saivenkatakrish/rice-sorting-lvds-camera-synchronization/rice-sorting-lvds-camera-synchronization/Documentation/system_architecture.png

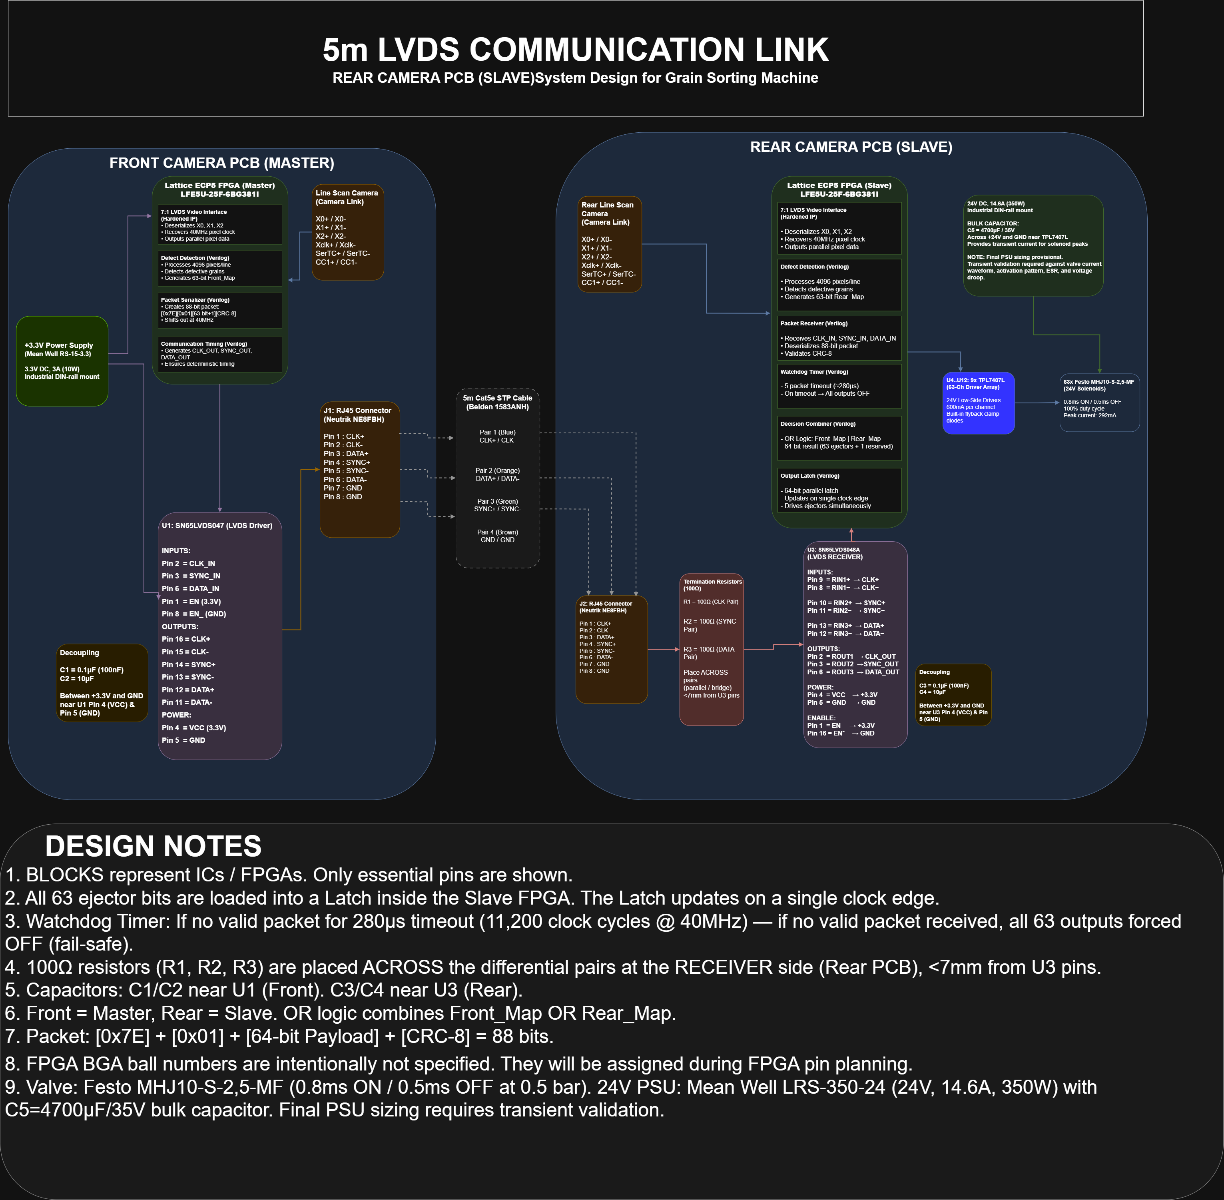
rice-sorting-lvds-camera-synchronization/Documentation/system_architecture.png
