saivenkatakrish/rice-sorting-lvds-camera-synchronization/rice-sorting-lvds-camera-synchronization/BOM/BOM_Rice_Sorter_MACHINE.xlsx

Bill of Materials — Rice Sorter FPGA Board
S.NO | Reference(s) | Value | Description | MPN / Part No. | Quantity | Datasheet
1 | C1, C4, C5, C11, C13, C18, C23, C24, C_BULK_3V3, C_BULK_3V_1 | 10µF | Ceramic Capacitor 10µF 10V X5R 0603 | GRM188R61A106KE69D | 10 | Datasheet ↗ (https://datasheet.octopart.com/GRM188R61A106KE69D-Murata-datasheet-138742815.pdf)
2 | C2, C6, C7, C8, C9, C10, C15, C16, C19, C20, C21, C22, C25, C26, C27, C28, C29, C30, C31, C32, C33, C_FLASH_DEC1, C_FLASH_DEC_1, C_HF_IO1, C_HF_IO_1, C_HF_IO_2, C_HF_IO_3, C_HF_IO_4, C_HF_IO_5 | 0.1µF | Ceramic Capacitor 100nF 10V X5R 0402 | GRM155R61A104KA01D | 29 | Datasheet ↗ (https://datasheet.octopart.com/GRM155R61A104KA01D-Murata-datasheet-140689730.pdf)
3 | C3, C12, C14, C17 | 22µF | Ceramic Capacitor 22µF 10V X5R 0805 | GRM219R61A226MEA0D | 4 | Datasheet ↗ (https://datasheet.octopart.com/GRM219R61A226MEA0D-Murata-datasheet-140706695.pdf)
4 | C34 | 4700µF | Electrolytic Capacitor 4700µF 35V Radial | ECA-1VHG472 | 1 | Datasheet ↗ (https://datasheet.octopart.com/ECA1VHG472-Panasonic-datasheet-182100703.pdf)
5 | CH1, CH2, CH3, CH4, CH5, CH6, CH7, CH8, CH9 | TPL7407LADR | 7-Channel NPN Open-Drain Driver 600mA SOIC-16 | TPL7407LADR | 9 | Datasheet ↗ (https://www.ti.com/lit/ds/symlink/tpl7407l.pdf)
6 | G1 | SN65LVDS048A_D_16 | Quad LVDS Line Receiver 400Mbps SOIC-16 | SN65LVDS048A | 1 | Datasheet ↗ (https://www.ti.com/lit/ds/symlink/sn65lvds048a.pdf?ts=1787949158249)
7 | J1, J5 | RJ45 | RJ45 Ethernet Jack with Magnetics 8P8C | CRJ068-1-SMT | 2 | Datasheet ↗ (https://www.sameskydevices.com/product/resource/crj068-1-smt.pdf)
8 | J2, J6 | RS-15-3.3 | Mean Well RS-15-3.3 PSU 15W 3.3V 3A | RS-15-3.3 | 2 | Datasheet ↗ (https://www.meanwell.com/webapp/product/search.aspx?prod=RS-15)
9 | J3, J4 | JTAG | ARM JTAG/SWD 10-Pin 1.27mm Debug Header | FTSH-105-01-F-DV-K | 2 | Datasheet ↗ (https://datasheet.octopart.com/FTSH-105-01-F-DV-K-Samtec-datasheet-140825048.pdf)
10 | J7 | LRS-350-24 | Mean Well LRS-350-24 PSU 350W 24V 14.6A | LRS-350-24 | 1 | Datasheet ↗ (https://www.meanwell.com/webapp/product/search.aspx?prod=LRS-350)
11 | J_CAM1, J_CAM2 | Camera Link (MDR-26) | Camera Link MDR-26 26-Pin Connector | 3M 10226-52A2JL | 2 | Datasheet ↗ (https://multimedia.3m.com/mws/media/2360684O/3m-camera-link-industrial-camera-cable-assembly-mdr-1wl26-series-tech-data-sheet.pdf)
12 | L1, L3 | 1.5µH | Power Inductor 1.5µH 3.6A SRR4028 | SRP3012TA-1R5M | 2 | Datasheet ↗ (https://www.bourns.com/docs/Product-Datasheets/SRP3012TA.pdf)
13 | L2, L4 | 2.2µH | Power Inductor 2.2µH 2.8A SRR4028 | SRR4028-2R2Y | 2 | Datasheet ↗ (https://www.bourns.com/docs/Product-Datasheets/SRR4028.pdf)
14 | R1, R10 | 30.1 kΩ | Resistor 30.1kΩ 1% 0402 | ERJ-2RKF3012X | 2 | Datasheet ↗ (https://datasheet.octopart.com/ERJ2RKF3012X-Panasonic-datasheet-182147282.pdf)
15 | R2, R11 | 20.5kΩ | Resistor 20.5kΩ 1% 0402 | ERJ-2RKF2052X | 2 | Datasheet ↗ (https://datasheet.octopart.com/ERJ2RKF2052X-Panasonic-datasheet-82288794.pdf)
16 | R3, R8 | 31.6kΩ | Resistor 31.6kΩ 1% 0402 | ERJ-2RKF3162X | 2 | Datasheet ↗ (https://datasheet.octopart.com/ERJ2RKF3162X-Panasonic-datasheet-48891056.pdf)
17 | R4, R9, R_PU_CLK1, R_PU_CLK_1, R_PU_CS1, R_PU_CS_1, R_PU_MISO1, R_PU_MISO_1, R_PU_MOSI1, R_PU_MOSI_1 | 10kΩ | Resistor 10kΩ 1% 0402 | RC0402FR-0710KL | 10 | Datasheet ↗ (https://datasheet.octopart.com/ERJ-U02F1002X-Panasonic-datasheet-184398019.pdf)
18 | R5, R6, R7 | 100Ω | Resistor 100Ω 1% 0402 | RC0402FR-07100RL | 3 | Datasheet ↗ (https://datasheet.octopart.com/CR0402-FX-1000GLF-Bourns-datasheet-159578630.pdf)
19 | SV1 | FestoMHJ10-S-2,5-MF | Solinoid valve | MHJ10-S-2,5-MF | 63 | Datasheet ↗ (https://datasheet.octopart.com/MHJ10-S-2%2C5-MF-Festo-datasheet-114145736.pdf)
20 | U1 | SN65LVDS047D | Quad LVDS Line Driver 400Mbps SOIC-16 | SN65LVDS047DR | 1 | Datasheet ↗ (https://www.ti.com/lit/ds/symlink/sn65lvds047.pdf)
21 | U2, U8 | TLV62084DSGx | Buck Converter 4A 0.9–5.5V WSON-8 | TLV62084ADSGR | 2 | Datasheet ↗ (https://www.ti.com/lit/ds/symlink/tlv62084a.pdf)
22 | U3, U7 | TLV62568DBV | Buck Converter 3A 0.6–5.5V SOT-23-5 | TLV62568DBVR | 2 | Datasheet ↗ (https://www.ti.com/lit/ds/symlink/tlv62568.pdf)
23 | U4, U5 | LFE5U-25F-6BG381I | Lattice ECP5 FPGA 25K LUTs BGA381 | LFE5U-25F-6BG381I | 2 | Datasheet ↗ (https://datasheet.octopart.com/LFE5U-25F-6BG381I-Lattice-Semiconductor-datasheet-180556152.pdf)
24 | U6 | W25Q32JVSS | SPI Flash 32Mbit 3V 133MHz SOP8 | W25Q32JVSSIQ | 1 | Datasheet ↗ (https://datasheet.octopart.com/W25Q32JVSSIQ-Winbond-datasheet-181529420.pdf)
25 | _JTAG_VREF1, _JTAG_VREF_1 | 4.7kΩ | Resistor 4.7kΩ 1% 0402 | RC0402FR-074K7L | 2 | Datasheet ↗ (https://datasheet.octopart.com/ERJ-U02F4701X-Panasonic-datasheet-184398019.pdf)
26 |  | 1583ANH | Cat5e, Shielded Twisted Pair (STP / F-UTP) | 1583ANH | 1 | Datasheet ↗ (https://datasheet.octopart.com/1583ANH-F6H1000-Belden-datasheet-190301628.pdf)
27 |  | Teledyne DALSA Linea Mono 2K Camera Link | High Speed Dual Line CMOS Cameras |  | 2 | Datasheet ↗ (https://www.1stvision.com/cameras/dalsa/dataman/03-070-20066-01_Piranha4_CMOS_P4-CM-0xK100-00-R_20131115.pdf)
