saivenkatakrish/rice-sorting-lvds-camera-synchronization/rice-sorting-lvds-camera-synchronization/KiCad/schematc.kicad_sch

## KiCad design rice-sorting-lvds-camera-synchronization/KiCad/schematc.kicad_sch (2026-09-30)

Schematic: schematc.kicad_sch

Parts:
C1, C4, C5, C11, C13, C18, C23, C24: 10µF
C2, C6, C7, C8, C9, C10, C15, C16, C19, C20, C21, C22, C25, C26, C27, C28, C29, C30, C31, C32, C33: 0.1µF
C3, C12, C14, C17: 22µF
C34: 4700µF
CH1, CH2, CH3, CH4, CH5, CH6, CH7, CH8, CH9: TPL7407LADR; D16_TEX
C_BULK_3V3, C_BULK_3V_1: 10µF
C_FLASH_DEC1: 0.1µF
C_FLASH_DEC_1: 0.1µF
C_HF_IO1: 0.1µF
C_HF_IO_1, C_HF_IO_2, C_HF_IO_3, C_HF_IO_4, C_HF_IO_5: 0.1µF
G1: SN65LVDS048A_D_16; D16
J1, J5: RJ45
J2, J6: RS-15-3.3
J3, J4: JTAG
J7: LRS-350-24
J_CAM1, J_CAM2: Camera Link (MDR-26)
L1, L3: 1.5µH
L2, L4: 2.2µH
R1, R10: 30.1 kΩ
R2, R11: 20.5kΩ
R3, R8: 31.6kΩ
R4, R9: 10kΩ
R5, R6, R7: 100Ω
R_PU_CLK1: 10kΩ
R_PU_CLK_1: 10kΩ
R_PU_CS1: 10kΩ
R_PU_CS_1: 10kΩ
R_PU_MISO1: 10kΩ
R_PU_MISO_1: 10kΩ
R_PU_MOSI1: 10kΩ
R_PU_MOSI_1: 10kΩ
SV1: FestoMHJ10-S-2,5-MF
U1: SN65LVDS047D; SOIC-16_3.9x9.9mm_P1.27mm
U2, U8: TLV62084DSGx; Texas_DSG0008A_WSON-8-1EP_2x2mm_P0.5mm_EP0.9x1.6mm
U3, U7: TLV62568DBV; SOT-23-5
U4, U5: LFE5U-25F-6BG381I
U6: W25Q32JVSS; SOIC-8_5.3x5.3mm_P1.27mm
_JTAG_VREF1: 4.7kΩ
_JTAG_VREF_1: 4.7kΩ

Connections:
1.1V: L2.2
+2.5V: C2.+, C3.+, C4.+, R1.1
+3.3V: C1.+, C5.+, C6.+, C11.+, C_BULK_3V3.+, C_FLASH_DEC1.+, C_HF_IO1.+, C_HF_IO_1.+, C_HF_IO_2.+, J2.+3.3V (Pin_1), R_PU_CLK1.1, R_PU_CS1.1, R_PU_MISO1.1, R_PU_MOSI1.1, U1.1 (EN), U1.4 (VCC), U2.1 (EN), U2.8 (VIN), U3.1 (EN), U3.4 (VIN), U4.3 (~WP/IO_{2}), U4.7 (~HOLD/~RESET/IO_{3}), U4.8 (VCC), U5.F9 (VCCIO0[2]), U5.F10 (VCCIO0[2]), U5.F11 (VCCIO1[2]), U5.F12 (VCCIO1[2]), U5.H6 (VCCIO7[3]), U5.H7 (VCCIO7[3]), U5.H14 (VCCIO2[3]), U5.H15 (VCCIO2[3]), U5.J6 (VCCIO7[3]), U5.J15 (VCCIO2[3]), U5.L6 (VCCIO6[3]), U5.L7 (VCCIO6[3]), U5.L14 (VCCIO3[3]), U5.L15 (VCCIO3[3]), U5.M6 (VCCIO6[3]), U5.M15 (VCCIO3[3]), U5.P9 (VCCIO8[2]), U5.P10 (VCCIO8[2]), _JTAG_VREF1.1
+24V: C29.+, C34.+, CH1.9 (COM), J7.+24V (Pin_1)
GND: C1.-, C2.-, C3.-, C4.-, C5.-, C6.-, C7.-, C8.-, C9.-, C10.-, C11.-, C12.-, C13.-, C14.-, C15.-, C16.-, C17.-, C18.-, C19.-, C20.-, C21.-, C22.-, C23.-, C24.-, C25.-, C26.-, C27.-, C28.-, C29.-, C30.-, C31.-, C32.-, C33.-, C34.-, CH1.8 (GND), CH2.8 (GND), CH3.8 (GND), CH4.8 (GND), CH5.8 (GND), CH6.8 (GND), CH7.8 (GND), CH8.8 (GND), CH9.8 (GND), C_BULK_3V3.-, C_BULK_3V_1.-, C_FLASH_DEC1.-, C_FLASH_DEC_1.-, C_HF_IO1.-, C_HF_IO_1.-, C_HF_IO_2.-, C_HF_IO_3.-, C_HF_IO_4.-, C_HF_IO_5.-, G1.12 (GND), G1.16 (EN), J1.7, J1.8, J2.GND (Pin_2), J3.3 (GND), J3.5 (GND), J3.9 (GNDDetect), J4.3 (GND), J4.5 (GND), J4.9 (GNDDetect), J5.7, J5.8, J6.GND (Pin_2), J7.GND (Pin_2), J_CAM1.13 (GND), J_CAM2.13 (GND), R2.2, R4.2, R9.2, R11.2, U1.5 (GND), U1.8 (~EN), U2.2 (GND), U2.3 (GND), U2.9 (GND), U3.2 (GND), U4.4 (GND), U4.B7 (GND[99]), U4.B14 (GND[99]), U4.C19 (GND[99]), U4.D4 (GND[99]), U4.F7 (GND[99]), U4.F8 (GND[99]), U4.F13 (GND[99]), U4.F14 (GND[99]), U4.G4 (GND[99]), U4.G6 (GND[99]), U4.G7 (GND[99]), U4.G8 (GND[99]), U4.G9 (GND[99]), U4.G10 (GND[99]), U4.G11 (GND[99]), U4.G12 (GND[99]), U4.G13 (GND[99]), U4.G14 (GND[99]), U4.G15 (GND[99]), U4.G17 (GND[99]), U4.H19 (GND[99]), U4.J2 (GND[99]), U4.J7 (GND[99]), U4.J9 (GND[99]), U4.J10 (GND[99]), U4.J11 (GND[99]), U4.J12 (GND[99]), U4.J14 (GND[99]), U4.K6 (GND[99]), U4.K7 (GND[99]), U4.K9 (GND[99]), U4.K10 (GND[99]), U4.K11 (GND[99]), U4.K12 (GND[99]), U4.K14 (GND[99]), U4.K15 (GND[99]), U4.L9 (GND[99]), U4.L10 (GND[99]), U4.L11 (GND[99]), U4.L12 (GND[99]), U4.M2 (GND[99]), U4.M7 (GND[99]), U4.M9 (GND[99]), U4.M10 (GND[99]), U4.M11 (GND[99]), U4.M12 (GND[99]), U4.M14 (GND[99]), U4.M16 (GND[99]), U4.N6 (GND[99]), U4.N7 (GND[99]), U4.N14 (GND[99]), U4.N15 (GND[99]), U4.P7 (GND[99]), U4.P8 (GND[99]), U4.P11 (GND[99]), U4.P12 (GND[99]), U4.P13 (GND[99]), U4.P14 (GND[99]), U4.R19 (GND[99]), U4.T6 (GND[99]), U4.T7 (GND[99]), U4.T8 (GND[99]), U4.T9 (GND[99]), U4.T10 (GND[99]), U4.U6 (GND[99]), U4.U7 (GND[99]), U4.U8 (GND[99]), U4.U9 (GND[99]), U4.U10 (GND[99]), U4.U11 (GND[99]), U4.U12 (GND[99]), U4.U13 (GND[99]), U4.U14 (GND[99]), U4.V5 (GND[99]), U4.V6 (GND[99]), U4.V7 (GND[99]), U4.V8 (GND[99]), U4.V9 (GND[99]), U4.V10 (GND[99]), U4.V11 (GND[99]), U4.V12 (GND[99]), U4.V13 (GND[99]), U4.V14 (GND[99]), U4.V15 (GND[99]), U4.V16 (GND[99]), U4.V19 (GND[99]), U4.V20 (GND[99]), U4.W6 (GND[99]), U4.W7 (GND[99]), U4.W12 (GND[99]), U4.W15 (GND[99]), U4.W16 (GND[99]), U4.W19 (GND[99]), U4.Y5 (GND[99]), U4.Y6 (GND[99]), U4.Y7 (GND[99]), U4.Y8 (GND[99]), U4.Y11 (GND[99]), U4.Y12 (GND[99]), U5.B7 (GND[99]), U5.B14 (GND[99]), U5.C19 (GND[99]), U5.D4 (GND[99]), U5.F7 (GND[99]), U5.F8 (GND[99]), U5.F13 (GND[99]), U5.F14 (GND[99]), U5.G4 (GND[99]), U5.G6 (GND[99]), U5.G7 (GND[99]), U5.G8 (GND[99]), U5.G9 (GND[99]), U5.G10 (GND[99]), U5.G11 (GND[99]), U5.G12 (GND[99]), U5.G13 (GND[99]), U5.G14 (GND[99]), U5.G15 (GND[99]), U5.G17 (GND[99]), U5.H19 (GND[99]), U5.J2 (GND[99]), U5.J7 (GND[99]), U5.J9 (GND[99]), U5.J10 (GND[99]), U5.J11 (GND[99]), U5.J12 (GND[99]), U5.J14 (GND[99]), U5.K6 (GND[99]), U5.K7 (GND[99]), U5.K9 (GND[99]), U5.K10 (GND[99]), U5.K11 (GND[99]), U5.K12 (GND[99]), U5.K14 (GND[99]), U5.K15 (GND[99]), U5.L9 (GND[99]), U5.L10 (GND[99]), U5.L11 (GND[99]), U5.L12 (GND[99]), U5.M2 (GND[99]), U5.M7 (GND[99]), U5.M9 (GND[99]), U5.M10 (GND[99]), U5.M11 (GND[99]), U5.M12 (GND[99]), U5.M14 (GND[99]), U5.M16 (GND[99]), U5.N6 (GND[99]), U5.N7 (GND[99]), U5.N14 (GND[99]), U5.N15 (GND[99]), U5.P7 (GND[99]), U5.P8 (GND[99]), U5.P11 (GND[99]), U5.P12 (GND[99]), U5.P13 (GND[99]), U5.P14 (GND[99]), U5.R19 (GND[99]), U5.T6 (GND[99]), U5.T7 (GND[99]), U5.T8 (GND[99]), U5.T9 (GND[99]), U5.T10 (GND[99]), U5.U6 (GND[99]), U5.U7 (GND[99]), U5.U8 (GND[99]), U5.U9 (GND[99]), U5.U10 (GND[99]), U5.U11 (GND[99]), U5.U12 (GND[99]), U5.U13 (GND[99]), U5.U14 (GND[99]), U5.V5 (GND[99]), U5.V6 (GND[99]), U5.V7 (GND[99]), U5.V8 (GND[99]), U5.V9 (GND[99]), U5.V10 (GND[99]), U5.V11 (GND[99]), U5.V12 (GND[99]), U5.V13 (GND[99]), U5.V14 (GND[99]), U5.V15 (GND[99]), U5.V16 (GND[99]), U5.V19 (GND[99]), U5.V20 (GND[99]), U5.W6 (GND[99]), U5.W7 (GND[99]), U5.W12 (GND[99]), U5.W15 (GND[99]), U5.W16 (GND[99]), U5.W19 (GND[99]), U5.Y5 (GND[99]), U5.Y6 (GND[99]), U5.Y7 (GND[99]), U5.Y8 (GND[99]), U5.Y11 (GND[99]), U5.Y12 (GND[99]), U6.4 (GND), U7.2 (GND), U8.2 (GND), U8.3 (GND), U8.9 (GND)
unnamed: C7.+, C8.+, C9.+, C10.+, U2.5 (VOS), U5.H8 (VCC[20]), U5.H9 (VCC[20]), U5.H10 (VCC[20]), U5.H11 (VCC[20]), U5.H12 (VCC[20]), U5.H13 (VCC[20]), U5.J8 (VCC[20]), U5.J13 (VCC[20]), U5.K8 (VCC[20]), U5.K13 (VCC[20]), U5.L8 (VCC[20]), U5.L13 (VCC[20]), U5.M8 (VCC[20]), U5.M13 (VCC[20]), U5.N8 (VCC[20]), U5.N9 (VCC[20]), U5.N10 (VCC[20]), U5.N11 (VCC[20]), U5.N12 (VCC[20]), U5.N13 (VCC[20])
unnamed: C12.+, R3.1, U5.F6 (VCCAUX[4]), U5.F15 (VCCAUX[4]), U5.P6 (VCCAUX[4]), U5.P15 (VCCAUX[4])
unnamed: C13.+, C14.+, C15.+, R10.1
unnamed: C16.+, C18.+, C23.+, C24.+, C_BULK_3V_1.+, C_FLASH_DEC_1.+, C_HF_IO_3.+, C_HF_IO_4.+, C_HF_IO_5.+, G1.9 (*EN), G1.13 (VCC), J6.+3.3V (Pin_1), R_PU_CLK_1.1, R_PU_CS_1.1, R_PU_MISO_1.1, R_PU_MOSI_1.1, U4.F9 (VCCIO0[2]), U4.F10 (VCCIO0[2]), U4.F11 (VCCIO1[2]), U4.F12 (VCCIO1[2]), U4.H6 (VCCIO7[3]), U4.H7 (VCCIO7[3]), U4.H14 (VCCIO2[3]), U4.H15 (VCCIO2[3]), U4.J6 (VCCIO7[3]), U4.J15 (VCCIO2[3]), U4.L6 (VCCIO6[3]), U4.L7 (VCCIO6[3]), U4.L14 (VCCIO3[3]), U4.L15 (VCCIO3[3]), U4.M6 (VCCIO6[3]), U4.M15 (VCCIO3[3]), U4.P9 (VCCIO8[2]), U4.P10 (VCCIO8[2]), U6.3 (~WP/IO_{2}), U6.7 (~HOLD/~RESET/IO_{3}), U6.8 (VCC), U7.1 (EN), U7.4 (VIN), U8.1 (EN), U8.8 (VIN), _JTAG_VREF_1.1
unnamed: C17.+, R8.1, U4.F6 (VCCAUX[4]), U4.F15 (VCCAUX[4]), U4.P6 (VCCAUX[4]), U4.P15 (VCCAUX[4])
unnamed: C19.+, C20.+, C21.+, C22.+, U4.H8 (VCC[20]), U4.H9 (VCC[20]), U4.H10 (VCC[20]), U4.H11 (VCC[20]), U4.H12 (VCC[20]), U4.H13 (VCC[20]), U4.J8 (VCC[20]), U4.J13 (VCC[20]), U4.K8 (VCC[20]), U4.K13 (VCC[20]), U4.L8 (VCC[20]), U4.L13 (VCC[20]), U4.M8 (VCC[20]), U4.M13 (VCC[20]), U4.N8 (VCC[20]), U4.N9 (VCC[20]), U4.N10 (VCC[20]), U4.N11 (VCC[20]), U4.N12 (VCC[20]), U4.N13 (VCC[20]), U8.5 (VOS)
unnamed: C25.+, CH9.9 (COM)
unnamed: C26.+, CH5.9 (COM)
unnamed: C27.+, CH3.9 (COM)
unnamed: C28.+, CH8.9 (COM)
unnamed: C30.+, CH7.9 (COM)
unnamed: C31.+, CH6.9 (COM)
unnamed: C32.+, CH2.9 (COM)
unnamed: C33.+, CH4.9 (COM)
unnamed: CH1.1 (IN1), U4.A4 (PL2A/+/HS/LDQ8)
unnamed: CH1.2 (IN2), U4.A5 (PL2B/-/HS/LDQ8)
unnamed: CH1.3 (IN3), U4.B5 (PL2C/+/LDQ8)
unnamed: CH1.4 (IN4), U4.C5 (PL2D/-/LDQ8)
unnamed: CH1.5 (IN5), U4.C4 (PL5A/+/HS/LDQ8)
unnamed: CH1.6 (IN6), U4.B4 (PL5B/-/HS/LDQ8)
unnamed: CH1.7 (IN7), U4.A3 (PL5C/+/LDQ8)
unnamed: CH1.10 (OUT7), SV1.7
unnamed: CH1.11 (OUT6), SV1.6
unnamed: CH1.12 (OUT5), SV1.5
unnamed: CH1.13 (OUT4), SV1.4
unnamed: CH1.14 (OUT3), SV1.3
unnamed: CH1.15 (OUT2), SV1.2
unnamed: CH1.16 (OUT1), SV1.1
unnamed: CH2.1 (IN1), U4.B3 (PL5D/-/LDQ8)
unnamed: CH2.2 (IN2), U4.E4 (PL8A/+/HS/LDQS8)
unnamed: CH2.3 (IN3), U4.D5 (PL8B/-/HS/LDQSN8)
unnamed: CH2.4 (IN4), U4.C3 (PL8C/+/LDQ8)
unnamed: CH2.5 (IN5), U4.D3 (PL8D/-/LDQ8)
unnamed: CH2.6 (IN6), U4.F4 (PL11A/+/HS/LDQ8)
unnamed: CH2.7 (IN7), U4.E3 (PL11B/-/HS/LDQ8)
unnamed: CH2.10 (OUT7), SV1.14
unnamed: CH2.11 (OUT6), SV1.13
unnamed: CH2.12 (OUT5), SV1.12
unnamed: CH2.13 (OUT4), SV1.11
unnamed: CH2.14 (OUT3), SV1.10
unnamed: CH2.15 (OUT2), SV1.9
unnamed: CH2.16 (OUT1), SV1.8
unnamed: CH3.1 (IN1), U4.E5 (PL11C/+/LDQ8)
unnamed: CH3.2 (IN2), U4.F5 (PL11D/-/LDQ8)
unnamed: CH3.3 (IN3), U4.A2 (PL14A/+/HS/LDQ20)
unnamed: CH3.4 (IN4), U4.B1 (PL14B/-/HS/LDQ20)
unnamed: CH3.5 (IN5), U4.B2 (PL14C/+/VREF1_7/LDQ20)
unnamed: CH3.6 (IN6), U4.C2 (PL14D/-/LDQ20)
unnamed: CH3.7 (IN7), U4.C1 (PL17A/+/HS/LDQ20)
unnamed: CH3.10 (OUT7), SV1.21
unnamed: CH3.11 (OUT6), SV1.20
unnamed: CH3.12 (OUT5), SV1.19
unnamed: CH3.13 (OUT4), SV1.18
unnamed: CH3.14 (OUT3), SV1.17
unnamed: CH3.15 (OUT2), SV1.16
unnamed: CH3.16 (OUT1), SV1.15
unnamed: CH4.1 (IN1), U4.D1 (PL17B/-/HS/LDQ20)
unnamed: CH4.2 (IN2), U4.D2 (PL17C/+/LDQ20)
unnamed: CH4.3 (IN3), U4.E1 (PL17D/-/LDQ20)
unnamed: CH4.4 (IN4), U4.H4 (PL20A/+/GR_PCLK7_1/HS/LDQS20)
unnamed: CH4.5 (IN5), U4.G5 (PL20B/-/HS/LDQSN20)
unnamed: CH4.6 (IN6), U4.H5 (PL20C/+/GR_PCLK7_0/LDQ20)
unnamed: CH4.7 (IN7), U4.H3 (PL20D/-/LDQ20)
unnamed: CH4.10 (OUT7), SV1.28
unnamed: CH4.11 (OUT6), SV1.27
unnamed: CH4.12 (OUT5), SV1.26
unnamed: CH4.13 (OUT4), SV1.25
unnamed: CH4.14 (OUT3), SV1.24
unnamed: CH4.15 (OUT2), SV1.23
unnamed: CH4.16 (OUT1), SV1.22
unnamed: CH5.1 (IN1), U4.G3 (PL23A/+/PCLKT7_1/HS/LDQ20)
unnamed: CH5.2 (IN2), U4.F3 (PL23B/-/PCLKC7_1/HS/LDQ20)
unnamed: CH5.3 (IN3), U4.F2 (PL23C/+/PCLKT7_0/LDQ20)
unnamed: CH5.4 (IN4), U4.E2 (PL23D/-/PCLKC7_0/LDQ20)
unnamed: CH5.5 (IN5), U4.G2 (PL26A/+/PCLKT6_1/HS/LDQ32)
unnamed: CH5.6 (IN6), U4.F1 (PL26B/-/PCLKC6_1/HS/LDQ32)
unnamed: CH5.7 (IN7), U4.H2 (PL26C/+/PCLKT6_0/LDQ32)
unnamed: CH5.10 (OUT7), SV1.35
unnamed: CH5.11 (OUT6), SV1.34
unnamed: CH5.12 (OUT5), SV1.33
unnamed: CH5.13 (OUT4), SV1.32
unnamed: CH5.14 (OUT3), SV1.31
unnamed: CH5.15 (OUT2), SV1.30
unnamed: CH5.16 (OUT1), SV1.29
unnamed: CH6.1 (IN1), U4.G1 (PL26D/-/PCLKC6_0/LDQ32)
unnamed: CH6.2 (IN2), U4.J4 (PL29A/+/GR_PCLK6_0/HS/LDQ32)
unnamed: CH6.3 (IN3), U4.J5 (PL29B/-/HS/LDQ32)
unnamed: CH6.4 (IN4), U4.J3 (PL29C/+/GR_PCLK6_1/LDQ32)
unnamed: CH6.5 (IN5), U4.K3 (PL29D/-/LDQ32)
unnamed: CH6.6 (IN6), U4.K2 (PL32A/+/HS/LDQS32)
unnamed: CH6.7 (IN7), U4.J1 (PL32B/-/HS/LDQSN32)
unnamed: CH6.10 (OUT7), SV1.42
unnamed: CH6.11 (OUT6), SV1.41
unnamed: CH6.12 (OUT5), SV1.40
unnamed: CH6.13 (OUT4), SV1.39
unnamed: CH6.14 (OUT3), SV1.38
unnamed: CH6.15 (OUT2), SV1.37
unnamed: CH6.16 (OUT1), SV1.36
unnamed: CH7.1 (IN1), U4.H1 (PL32C/+/LDQ32)
unnamed: CH7.2 (IN2), U4.K1 (PL32D/-/LDQ32)
unnamed: CH7.3 (IN3), U4.K4 (PL35A/+/HS/LDQ32)
unnamed: CH7.4 (IN4), U4.K5 (PL35B/-/VREF1_6/HS/LDQ32)
unnamed: CH7.5 (IN5), U4.L4 (PL35C/+/LDQ32)
unnamed: CH7.6 (IN6), U4.L5 (PL35D/-/LDQ32)
unnamed: CH7.7 (IN7), U4.M4 (PL38A/+/HS/LDQ44)
unnamed: CH7.10 (OUT7), SV1.49
unnamed: CH7.11 (OUT6), SV1.48
unnamed: CH7.12 (OUT5), SV1.47
unnamed: CH7.13 (OUT4), SV1.46
unnamed: CH7.14 (OUT3), SV1.45
unnamed: CH7.15 (OUT2), SV1.44
unnamed: CH7.16 (OUT1), SV1.43
unnamed: CH8.1 (IN1), U4.N5 (PL38B/-/HS/LDQ44)
unnamed: CH8.2 (IN2), U4.N4 (PL38C/+/LDQ44)
unnamed: CH8.3 (IN3), U4.P5 (PL38D/-/LDQ44)
unnamed: CH8.4 (IN4), U4.N3 (PL41A/+/HS/LDQ44)
unnamed: CH8.5 (IN5), U4.M3 (PL41B/-/HS/LDQ44)
unnamed: CH8.6 (IN6), U4.L3 (PL41C/+/LDQ44)
unnamed: CH8.7 (IN7), U4.L2 (PL41D/-/LDQ44)
unnamed: CH8.10 (OUT7), SV1.56
unnamed: CH8.11 (OUT6), SV1.55
unnamed: CH8.12 (OUT5), SV1.54
unnamed: CH8.13 (OUT4), SV1.53
unnamed: CH8.14 (OUT3), SV1.52
unnamed: CH8.15 (OUT2), SV1.51
unnamed: CH8.16 (OUT1), SV1.50
unnamed: CH9.1 (IN1), U4.N2 (PL44A/+/HS/LDQS44)
unnamed: CH9.2 (IN2), U4.M1 (PL44B/-/HS/LDQSN44)
unnamed: CH9.3 (IN3), U4.L1 (PL44C/+/LDQ44)
unnamed: CH9.4 (IN4), U4.N1 (PL44D/-/LDQ44)
unnamed: CH9.5 (IN5), U4.P1 (PL47A/+/HS/LDQ44)
unnamed: CH9.6 (IN6), U4.P2 (PL47B/-/HS/LDQ44)
unnamed: CH9.7 (IN7), U4.P3 (PL47C/+/LLC_GPLL0T_IN/LDQ44)
unnamed: CH9.10 (OUT7), SV1.63 (Pin_60)
unnamed: CH9.11 (OUT6), SV1.62 (Pin_60)
unnamed: CH9.12 (OUT5), SV1.61 (Pin_60)
unnamed: CH9.13 (OUT4), SV1.60
unnamed: CH9.14 (OUT3), SV1.59
unnamed: CH9.15 (OUT2), SV1.58
unnamed: CH9.16 (OUT1), SV1.57
unnamed: G1.1 (RIN1-), J5.2, R6.1
unnamed: G1.2 (RIN1+), J5.1, R6.2
unnamed: G1.3 (RIN2+), J5.4, R7.1
unnamed: G1.4 (RIN2-), J5.5, R7.2
unnamed: G1.5 (RIN3-), J5.6, R5.1
unnamed: G1.6 (RIN3+), J5.3, R5.2
unnamed: G1.11 (ROUT3), U4.E16 (PR2C/+/RDQ8)
unnamed: G1.14 (ROUT2), U4.D17 (PR2B/-/S0_IN/HS/RDQ8)
unnamed: G1.15 (ROUT1), U4.C18 (PR2A/+/HS/RDQ8)
unnamed: J1.1, U1.16 (DOUT1+)
unnamed: J1.2, U1.15 (DOUT1-)
unnamed: J1.3, U1.11 (DOUT3+)
unnamed: J1.4, U1.14 (DOUT2+)
unnamed: J1.5, U1.13 (DOUT2-)
unnamed: J1.6, U1.12 (DOUT3-)
unnamed: J3.1 (VTref), _JTAG_VREF1.2
unnamed: J3.2 (SWDIO/TMS), U5.U5 (TMS)
unnamed: J3.4 (SWCLK/TCK), U5.T5 (TCK)
unnamed: J3.6 (SWO/TDO), U5.V4 (TDO)
unnamed: J3.8 (NC/TDI), U5.R5 (TDI)
unnamed: J4.1 (VTref), _JTAG_VREF_1.2
unnamed: J4.2 (SWDIO/TMS), U4.U5 (TMS)
unnamed: J4.4 (SWCLK/TCK), U4.T5 (TCK)
unnamed: J4.6 (SWO/TDO), U4.V4 (TDO)
unnamed: J4.8 (NC/TDI), U4.R5 (TDI)
unnamed: J_CAM1.1 (X0-), U5.B6 (PT4B/-)
unnamed: J_CAM1.2 (X0+), U5.A6 (PT4A/+)
unnamed: J_CAM1.3 (X1-), U5.D6 (PT6B/-)
unnamed: J_CAM1.4 (X1+), U5.E6 (PT6A/+)
unnamed: J_CAM1.5 (X2-), U5.D7 (PT9B/-)
unnamed: J_CAM1.6 (X2+), U5.E7 (PT9A/+)
unnamed: J_CAM1.7 (Xclk-), U5.A11 (PT27B/-/PCLKC0_1)
unnamed: J_CAM1.8 (Xclk+), U5.A10 (PT27A/+/PCLKT0_1)
unnamed: J_CAM1.9 (SerTC-), U5.E9 (PT20B/-)
unnamed: J_CAM1.10 (SerTC+), U5.D9 (PT20A/+)
unnamed: J_CAM1.11 (CC1-), U5.C7 (PT11B/-)
unnamed: J_CAM1.12 (CC1+), U5.C6 (PT11A/+)
unnamed: J_CAM2.1 (X0-), U4.B6 (PT4B/-)
unnamed: J_CAM2.2 (X0+), U4.A6 (PT4A/+)
unnamed: J_CAM2.3 (X1-), U4.D6 (PT6B/-)
unnamed: J_CAM2.4 (X1+), U4.E6 (PT6A/+)
unnamed: J_CAM2.5 (X2-), U4.D7 (PT9B/-)
unnamed: J_CAM2.6 (X2+), U4.E7 (PT9A/+)
unnamed: J_CAM2.7 (Xclk-), U4.A11 (PT27B/-/PCLKC0_1)
unnamed: J_CAM2.8 (Xclk+), U4.A10 (PT27A/+/PCLKT0_1)
unnamed: J_CAM2.9 (SerTC-), U4.E9 (PT20B/-)
unnamed: J_CAM2.10 (SerTC+), U4.D9 (PT20A/+)
unnamed: J_CAM2.11 (CC1-), U4.C7 (PT11B/-)
unnamed: J_CAM2.12 (CC1+), U4.C6 (PT11A/+)
unnamed: L1.1, U2.7 (SW)
unnamed: L2.1, U3.3 (SW)
unnamed: L3.1, U8.7 (SW)
unnamed: L4.1, U7.3 (SW)
unnamed: R1.2, R2.1, U2.4 (FB)
unnamed: R3.2, R4.1, U3.5 (FB)
unnamed: R8.2, R9.1, U7.5 (FB)
unnamed: R10.2, R11.1, U8.4 (FB)
unnamed: R_PU_CLK1.2, U4.6 (CLK), U5.U3 (CCLK/MCLK/SCK)
unnamed: R_PU_CLK_1.2, U4.U3 (CCLK/MCLK/SCK), U6.6 (CLK)
unnamed: R_PU_CS1.2, U4.1 (~CS), U5.T2 (PB13A/+/SN/CSN)
unnamed: R_PU_CS_1.2, U4.T2 (PB13A/+/SN/CSN), U6.1 (~CS)
unnamed: R_PU_MISO1.2, U4.2 (DO/IO_{1}), U5.V2 (PB11A/+/D1/MISO/IO1)
unnamed: R_PU_MISO_1.2, U4.V2 (PB11A/+/D1/MISO/IO1), U6.2 (DO/IO_{1})
unnamed: R_PU_MOSI1.2, U4.5 (DI/IO_{0}), U5.W2 (PB11B/-/D0/MOSI/IO0)
unnamed: R_PU_MOSI_1.2, U4.W2 (PB11B/-/D0/MOSI/IO0), U6.5 (DI/IO_{0})
unnamed: U1.2 (DIN1), U5.C18 (PR2A/+/HS/RDQ8)
unnamed: U1.3 (DIN2), U5.D17 (PR2B/-/S0_IN/HS/RDQ8)
unnamed: U1.6 (DIN3), U5.E16 (PR2C/+/RDQ8)
